JonasNowak/ns-conv/README.md

# Nintendo Switch v1 (Erista) → Clamshell Cyberdeck (`ns-conv`)

A complete, reversible hardware conversion that transforms an unpatched first-generation **Nintendo Switch v1 (2017 Erista, `HAC-001`)** into a **translucent lilac clamshell cyberdeck** integrating a **Drop × OLKB MIT Planck 40% ortholinear keyboard**, a **compact 38 mm USB HID trackball**, and an **internal slim UN 38.3 USB-C PD power bank**.

> [!TIP]
> **Interactive 3D WebGL CAD Studio & All-in-One Documentation Portal:**
> Open **[`docs/index.html`](docs/index.html)** (or visit the deployed GitHub Pages site) to spin the 3D cyberdeck, animate the clamshell lid (`0°–125°`), explode all 7 OpenSCAD STL meshes, switch between all 6 premade SLA factory colors, and browse/search all 10 engineering guides in one interactive app!

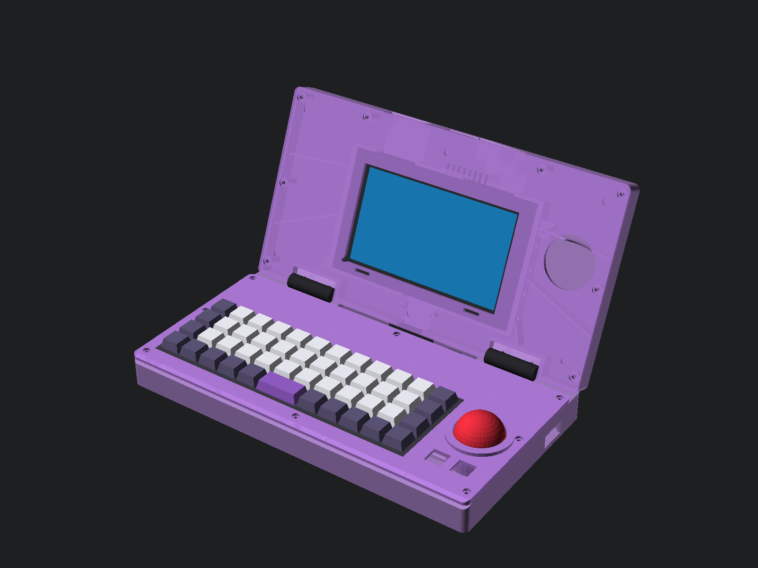
[picture p1: docs/renders/assembly_open_iso.png]
Open Clamshell Cyberdeck Render


| Exploded Assembly View | Closed Clamshell View (`0°`) |
| :---: | :---: |
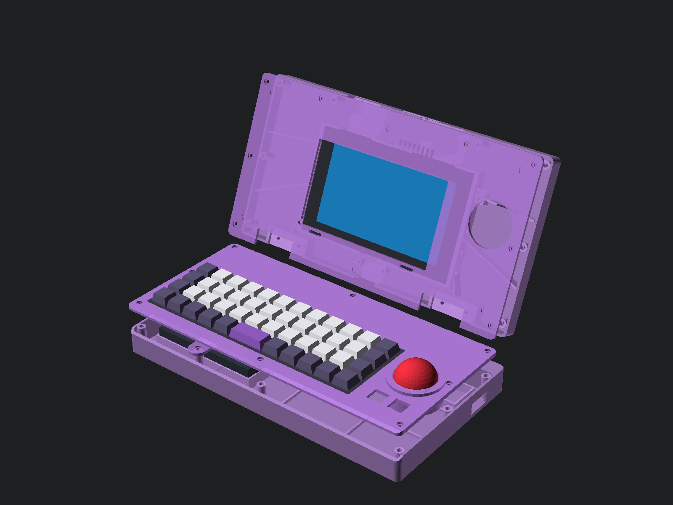
[picture p2: docs/renders/assembly_exploded.png]
Exploded View
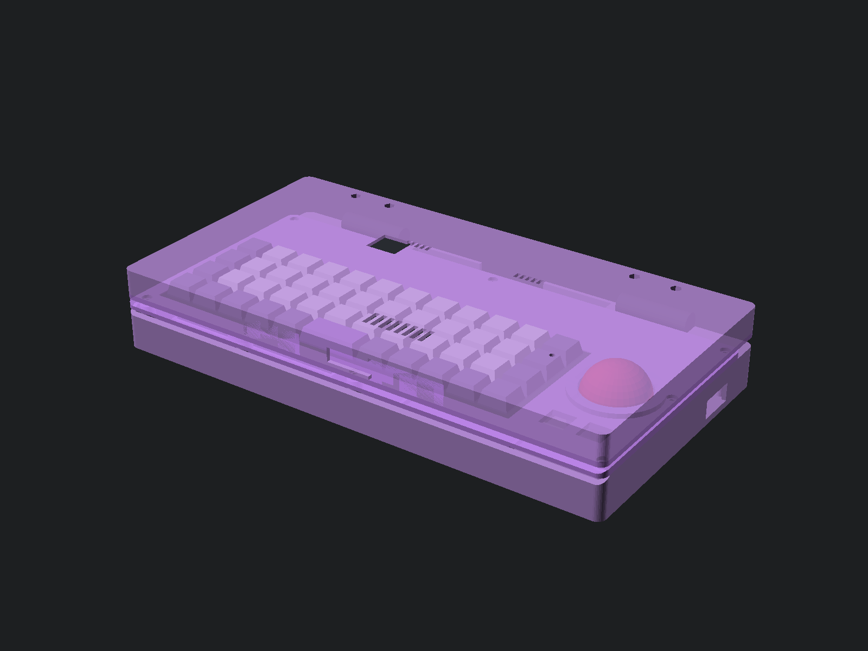
[picture p3: docs/renders/assembly_closed.png]
Closed View
|  |  |

---

## System Architecture Overview

```mermaid
flowchart LR
    subgraph LID["Upper Lid Assembly (Translucent Lilac SLA)"]
        SW_CORE["Switch v1 Core Assembly<br/>(LCD + Digitizer + Magnesium Midframe +<br/>Mainboard + Fan + 4310mAh Int. Battery)"]
        RCM_BTN["Recessed RCM Momentary Trigger<br/>(Right Rail Pin 10 → GND)"]
        RCM_BTN --> SW_CORE
    end

    subgraph HINGE["Torque-Balanced Dual Axis"]
        F_HINGE["2× Friction Torque Hinges<br/>(~0.40 N·m combined, 100–120° hold)"]
        USBC_FPC["Flexible Coaxial USB-C 3.1 Ribbon<br/>(Strained-relieved through hinge channel)"]
    end

    subgraph BASE["Base Deck Assembly (Translucent Lilac SLA)"]
        HUB["Internal Compact USB-C PD Hub<br/>(PD 3.0 15V Pass-Through + 3× USB 2.0/3.0 HID)"]
        PLANCK["Drop × MIT Planck Keyboard<br/>(Recessed PCB + Plate, QMK 6KRO)"]
        TBALL["Integrated Trackball<br/>(Ploopy Nano 2 QMK / 38mm Ball)"]
        PBANK["Slim UN 38.3 USB-C PD Power Bank<br/>(15V/2.6A+ PD Output, Fused & Thermally Isolated)"]
        EXT_USBC["Rear Panel USB-C PD Input/Data Port<br/>(Payload Injection & Charging)"]

        PLANCK -->|USB 2.0 HID| HUB
        TBALL -->|USB 2.0 HID| HUB
        PBANK -->|15V USB-PD + Inline 5A Fuse| HUB
        EXT_USBC <-->|Charging / RCM Injection| PBANK
        EXT_USBC -.->|Direct Switch Mode / OTG| HUB
    end

    SW_CORE <-->|Bottom USB-C Port via Low-Profile 90° Plug| USBC_FPC
    USBC_FPC <--> HUB
```

### Core Design Principles

1. **Zero-Destruction Reversibility:** The Switch's factory-bonded LCD, capacitive digitizer, die-cast magnesium midframe, thermal heatpipe/fan, and internal 4310 mAh battery remain intact as a single structural module inside the upper lid. No PCB traces are cut, and the risky LCD/digitizer adhesive separation is completely avoided.
2. **No High-Speed MIPI DSI Extension Across the Hinge:** Prior art shows that passively extending the Switch's 53-pin MIPI DSI LCD ribbon across a hinge causes severe signal reflection and black-screen failures. Keeping the mainboard and display together in the lid means **only a single USB-C cable** crosses the hinge into the base.
3. **Horizon OS Safety First & Mainline Chimera Linux 6.18 (`chimera-l4s`):** Stock `sysNAND` remains 100% unmodified for online play. Custom firmware (**Kefir `v927` AIO**) and Linux (**[`../chimera-l4s`](../chimera-l4s) — Chimera Linux `aarch64` with Linux `6.18.0-enigma-r20-erista+`** + optional **Switchroot L4T Ubuntu** rescue path) run strictly from the external microSD card (`emmc=0`, `LABEL=SWR-CHI` + `emuNAND` with `exosphere`/`dns.mitm` telemetry blanking).
4. **Translucent Lilac Industrial 3D Printing:** All enclosure components are designed in parametric OpenSCAD (`cad/`) for **SLA Translucent Resin with custom Pantone Lilac dyeing** and clear UV-protective urethane coating via **PCBWay (`UTR-8100 Transparent`)** or **JLC3DP (`8001 Translucent`)**.

---

## Build Phase Status & Deliverables

This project is executed strictly phase-by-phase with user sign-off between phases:

| Phase | Deliverable | Document / Path | GitHub Issue | Status |
| :--- | :--- | :--- | :--- | :--- |
| **1** | **Research Summary** (Prior art, hardware verification, OS HID behavior, trackball & battery trade-offs) | [`docs/research.md`](docs/research.md) | [#1](https://github.com/JonasNowak/ns-conv/issues/1) | **Complete** |
| **2** | **Bill of Materials (BOM)** (Every part, tool, consumable, EUR pricing, suppliers & alternatives) | [`docs/bom.md`](docs/bom.md) & [`hardware/BOM.csv`](hardware/BOM.csv) | [#2](https://github.com/JonasNowak/ns-conv/issues/2) | **Complete** |
| **3** | **Teardown Plan** (Step-by-step Switch v1 & Drop Planck non-destructive disassembly) | [`docs/teardown.md`](docs/teardown.md) | [#3](https://github.com/JonasNowak/ns-conv/issues/3) | **Complete** |
| **4** | **Electronics & Wiring Plan** (USB-C hub vs harness, PD power-bank topology, fusing, thermals) | [`docs/wiring.md`](docs/wiring.md) & [`hardware/`](hardware/) | [#4](https://github.com/JonasNowak/ns-conv/issues/4) | **Complete** |
| **5** | **Parametric OpenSCAD CAD Package** (`config.scad`, lid, base, hinge brackets, jigs, STLs) | [`cad/`](cad/) & [`docs/cad-overview.md`](docs/cad-overview.md) | [#5](https://github.com/JonasNowak/ns-conv/issues/5) | **Complete** |
| **6** | **3D Print Order Specification** (PCBWay / JLC3DP all 6 premade factory SLA color options & test-fit jig) | [`docs/print-spec.md`](docs/print-spec.md) | [#6](https://github.com/JonasNowak/ns-conv/issues/6) | **Complete** |
| **7** | **Assembly Guide** (Step-by-step mechanical & electrical build, torque sequence, first boot) | [`docs/assembly.md`](docs/assembly.md) | [#7](https://github.com/JonasNowak/ns-conv/issues/7) | **Complete** |
| **8** | **Software Setup Guide** (`../chimera-l4s` Linux 6.18 Enigma R20 + Kefir `v927` `emuNAND` + SD deployment script) | [`docs/software.md`](docs/software.md) & [`software/`](software/) | [#8](https://github.com/JonasNowak/ns-conv/issues/8) | **Complete** |
| **9** | **Test & Acceptance Checklist** (Horizon OS, L4T Linux, USB HID, PD charging, thermals, hinges) | [`docs/testing.md`](docs/testing.md) | [#9](https://github.com/JonasNowak/ns-conv/issues/9) | **Complete** |
| **10** | **Risk Register** (Top 10 technical, safety, and ban risks with mitigations) | [`docs/risks.md`](docs/risks.md) | [#10](https://github.com/JonasNowak/ns-conv/issues/10) | **Complete** |

---

## Exposed External Ports & Wireless Connectivity Summary

- **Wi-Fi & Bluetooth (`BCM4356` 2×2 MIMO 802.11ac 2.4/5 GHz + BT 4.1):** Both factory Switch `U.FL` coaxial cables and flat PCB patch antennas remain plugged into the mainboard and sit inside the **100% RF-transparent non-conductive SLA upper lid (`2.5 mm` wall)**, preserving full dual-band Wi-Fi and wireless Joy-Con / Bluetooth range in both Horizon OS and L4T Ubuntu Linux.
- **Right-Side Flush I/O Window (`cad/base_bottom.scad`):** Exposes **`1× USB-A 3.0 SuperSpeed (5 Gbps)` port** + **`1× 4K HDMI` output port** directly from the internal 5-in-1 USB-C PD hub (`HUB-01`) for external flash drives, SDR dongles, Ethernet adapters, or an external monitor.
- **Rear Panel I/O (`cad/base_bottom.scad`):** Exposes **`1× USB-C PD Charging Socket (`CAB-03`)`**, the **Recessed Center RCM / Direct Switch USB-C Coupler Pocket**, and the **Master Battery Cutoff Switch (`ELC-02`)**.
- **Top & Bottom Lid I/O (`cad/lid_rear.scad`):** Exposes the Switch's native **Power button**, **Volume `+/-`**, **`3.5 mm` audio jack**, **Game Card slot**, **Top Heatsink Exhaust**, **Rear Intake Louvers**, **microSDXC slot**, and **Recessed RCM Momentary Pinhole Button (`RCM-01`)**.

---

## Repository Structure

```text
ns-conv/
├── README.md                 # Project overview, architecture, and build phase tracker
├── docs/
│   ├── research.md           # Phase 1: Prior art, donor verification & subsystem trade-offs
│   ├── bom.md                # Phase 2: Bill of Materials & EUR budget (AliExpress vs DE)
│   ├── teardown.md           # Phase 3: Non-destructive Switch v1 & Planck teardown
│   ├── wiring.md             # Phase 4: Internal USB-C hub, PD power bank & fusing plan
│   ├── cad-overview.md       # Phase 5: Dimensioned CAD overview & verification checklist
│   ├── print-spec.md         # Phase 6: PCBWay / JLC3DP premade SLA print specification
│   ├── assembly.md           # Phase 7: Mechanical assembly & first power-on guide
│   ├── software.md           # Phase 8: Full software guide (../chimera-l4s Linux 6.18 + Kefir v927)
│   ├── testing.md            # Phase 9: Test & acceptance checklist
│   ├── risks.md              # Phase 10: Top 10 risk register & recovery playbooks
│   └── renders/              # OpenSCAD PNG renders of all 7 parts + open/closed/exploded views
├── cad/                      # Phase 5: Parametric OpenSCAD sources, Makefile, STLs & 3MFs
├── hardware/                 # BOM.csv, wiring-diagram.mmd, and component datasheets.md
└── software/                 # deploy-chimera-kefir-sd.sh staging script & chimera-l4s integration
```
