JonasNowak/ns-conv/docs/renders/base_bottom.png

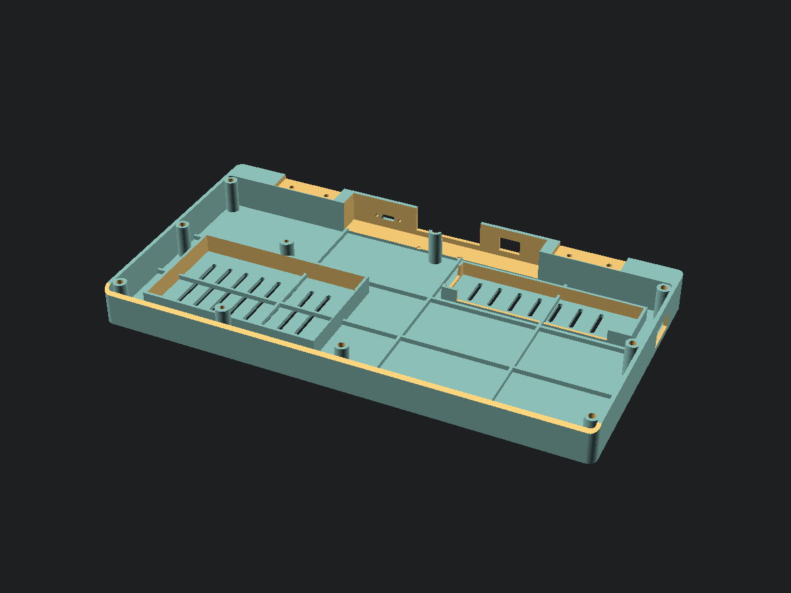
docs/renders/base_bottom.png
