JonasNowak/ns-conv/docs/renders/base_top_deck.png

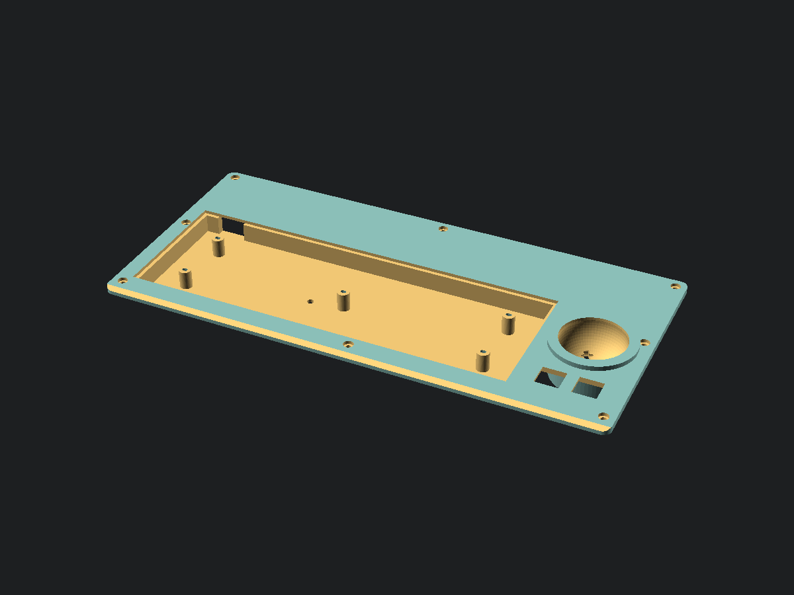
docs/renders/base_top_deck.png
