JonasNowak/ns-conv/docs/renders/battery_retainer.png

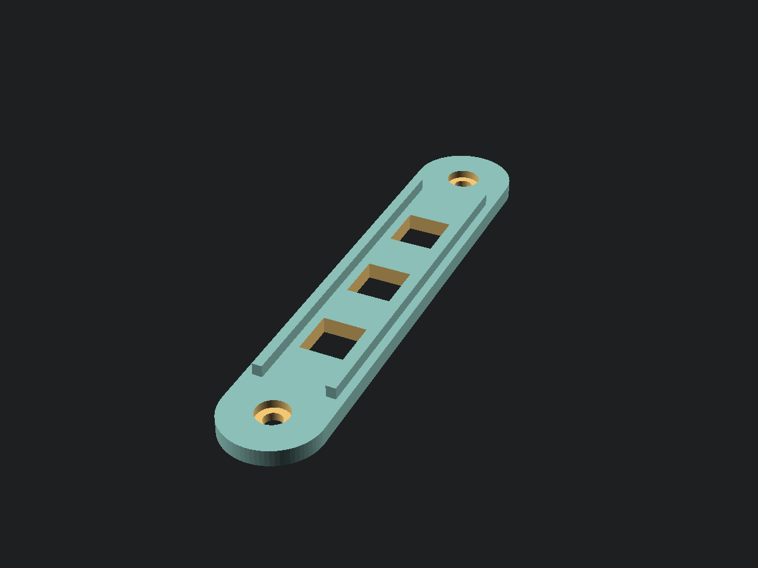
docs/renders/battery_retainer.png
