JonasNowak/ns-conv/docs/renders/cable_clamp.png

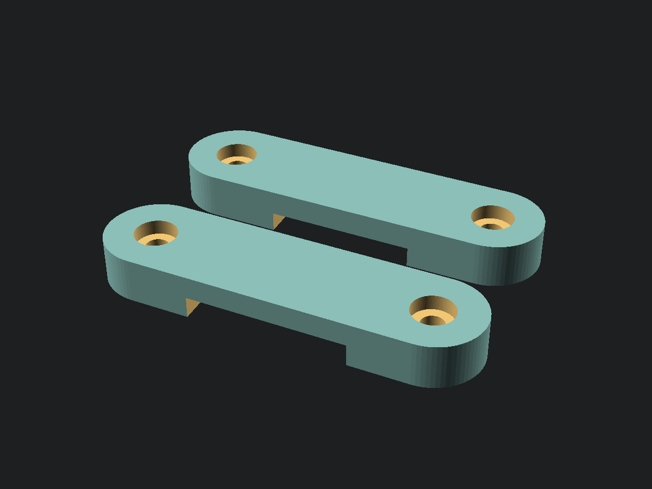
docs/renders/cable_clamp.png
