JonasNowak/ns-conv/docs/renders/lid_bezel.png

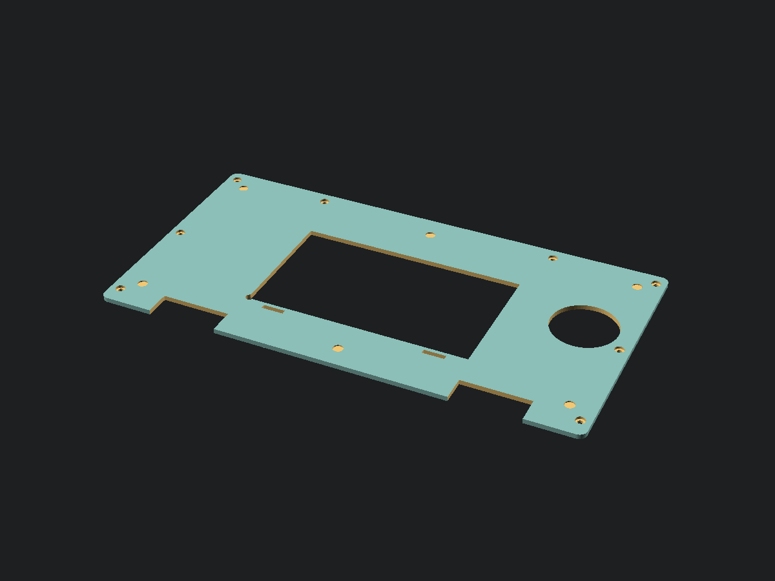
docs/renders/lid_bezel.png
