JonasNowak/ns-conv/hardware/BOM.csv

ID | Category | Component | Specification | Qty | AliExpress_Total_EUR | DE_Retail_Total_EUR | AliExpress_Search_URL | DE_Supplier_URL | Notes_And_Alternatives
DON-01 | Donor Hardware | Nintendo Switch v1 (2017 Erista) | MOD. HAC-001 unpatched Tegra X1 T210 | 1 | 0.00 | 0.00 | https://ismyswitchpatched.com/ | https://ismyswitchpatched.com/ | User-owned donor console
DON-02 | Donor Hardware | Drop x OLKB MIT Planck Keyboard | Planck Rev 6.x (233x81mm PCB + Plate + 47 MX Switches + Keycaps) | 1 | 0.00 | 0.00 | https://github.com/olkb/olkb_parts | https://github.com/olkb/olkb_parts | User-owned donor keyboard
DON-03 | Donor Hardware | Spare Right Joy-Con Rail / RCM Jig Parts | OEM or spare Right Joy-Con rail flex & RCM jig (Pin 10 RCM to GND) | 1 | 0.00 | 0.00 | https://ismyswitchpatched.com/ | https://ismyswitchpatched.com/ | User-owned spare Joy-Con hardware
PER-01 | Peripherals & Power | 38mm QMK Trackball (Ploopy Nano 2 Architecture) | 38mm ball + RP2040-Zero + PMW3360/PAW3222 breakout + 3x MR63ZZ bearings (QMK USB-C) | 1 | 21.50 | 60.00 | https://www.aliexpress.com/w/wholesale-PMW3360-module.html | https://ploopy.co/shop/nano-trackball/ | AliExpress DIY kit (21.50 EUR) vs pre-built Ploopy Nano 2 shipped to DE (60.00 EUR) or ProtoArc EM04 (18.50 EUR)
PWR-01 | Peripherals & Power | INIU Carry P50-E1 / BI-B62 45W Slim Power Bank | 10000mAh 37Wh 15V/3A USB-C PD Pass-Through UN38.3 (110x68x18.5mm 210g) | 1 | 25.99 | 33.99 | https://www.aliexpress.com/w/wholesale-INIU-45W-power-bank.html | https://www.amazon.de/s?k=INIU+45W+Powerbank+10000mAh | Ships from DE/PL EU warehouse; 20000mAh INIU P62-E1 65W alt (44.99 EUR)
HUB-01 | Peripherals & Power | 100W PD 5-in-1 USB-C Hub (UGREEN Revodok 105 / Baseus) | 100W USB-C PD Pass-Through + 3x USB-A + 4K HDMI (115x27x12mm) | 1 | 6.50 | 12.99 | https://www.aliexpress.com/w/wholesale-UGREEN-USB-C-Hub-100W-PD.html | https://www.amazon.de/s?k=UGREEN+Revodok+105+USB+C+Hub | Anker 332 5-in-1 100W PD alt (19.99 EUR)
STR-01 | Optional Storage & Tools | 256GB microSDXC U3 A2 V30 Card | Samsung PRO Plus or Lexar Play 256GB microSDXC | 1 | 16.90 | 22.99 | https://www.aliexpress.com/w/wholesale-Samsung-PRO-Plus-256GB.html | https://www.amazon.de/s?k=Samsung+PRO+Plus+256GB+microSDXC | Skip if already owned
CAB-01 | Cabling & Protection | 90-Degree Flat Flexible USB-C 3.1 Ribbon Cable | 20cm Right-Angle Male-to-Female FPC Ribbon 100W PD 10Gbps (Lid to Base) | 1 | 3.40 | 11.99 | https://www.aliexpress.com/w/wholesale-ADT-Link-USB-C-90-degree-flat-20cm.html | https://www.amazon.de/s?k=USB+C+90+Grad+Flachkabel+Verl%C3%A4ngerung+100W | Routes across hinge channel
CAB-02 | Cabling & Protection | Short Flat Silicone USB-A to USB-C Cables (2-Pack) | 15cm USB-A to USB-C data cables (Planck & Trackball to Hub) | 1 | 1.80 | 7.99 | https://www.aliexpress.com/w/wholesale-flat-silicone-USB-A-to-USB-C-15cm.html | https://www.amazon.de/s?k=USB+A+auf+USB+C+Kabel+15cm+2er | 2 cables included
CAB-03 | Cabling & Protection | Rear Panel-Mount USB-C PD Extension Socket | 20cm Female-to-Male M2/M3 Panel Mount 16mm pitch 100W PD | 1 | 2.10 | 8.99 | https://www.aliexpress.com/w/wholesale-USB-C-panel-mount-extension-cable-100W.html | https://www.amazon.de/s?k=USB+C+Einbaubuchse+Panel+Mount+100W | External rear charging & payload port
ELC-01 | Cabling & Protection | Inline 5A Blade Fuse Holder + 5A Fast Fuses | 16 AWG Inline Mini/ATO Blade Fuse Holder + 5A Fuses (VBUS protection) | 1 | 1.50 | 5.99 | https://www.aliexpress.com/w/wholesale-16AWG-inline-blade-fuse-holder-5A.html | https://www.amazon.de/s?k=Flachsicherungshalter+16AWG+5A | Mandatory battery line overcurrent fuse
ELC-02 | Cabling & Protection | USB-C PD Power Cutoff Switch Cable | 15-20cm Male-to-Female Inline High-Current Power Toggle Switch | 1 | 1.60 | 7.99 | https://www.aliexpress.com/w/wholesale-USB-C-switch-extension-cable.html | https://www.amazon.de/s?k=USB+C+Schalter+Kabel+Power+Switch | Cuts power bank output during storage
RCM-01 | Cabling & Protection | 6x6x5mm Momentary Tactile Pushbutton Switch | Through-hole/SMD tactile switch wired to spare Right Joy-Con rail Pin 10 & GND | 1 | 0.99 | 2.99 | https://www.aliexpress.com/w/wholesale-6x6x5mm-tactile-switch.html | https://www.amazon.de/s?k=Taster+6x6x5mm | Uses user-owned spare Joy-Con rail/RCM hardware
PRT-01 | 3D-Printed SLA Shell | Custom 7-Part SLA Enclosure Set (Turnkey Factory-Dyed Translucent Lilac) | PCBWay SLA UTR-8100 Transparent + Factory Pantone 2577C Lilac Dyeing + Clear Coat (incl. DE IOSS shipping) | 1 | 145.00 | 145.00 | https://www.pcbway.com/rapid-prototyping/manufacture/?type=2 | https://www.pcbway.com/rapid-prototyping/manufacture/?type=2 | 100% premade factory-dyed Translucent Lilac (145.00 EUR w/ clear internal clamps or 165.00 EUR all dyed; JLC3DP un-dyed 8001 clear alt: 50.00 EUR)
MEC-01 | Mechanical & Fasteners | Adjustable Friction Torque Hinges (42.9x36.5x12.7mm Pair) | Southco E6-10-301-20 / CL226 Screw-Adjustable Torque Hinges (0-0.80 Nm each) | 2 | 5.90 | 27.60 | https://www.aliexpress.com/w/wholesale-E6-10-301-hinge.html | https://de.rs-online.com/web/c/?searchTerm=E6-10-301-20 | Amazon.de pair alt: 14.99 EUR
MEC-02 | Mechanical & Fasteners | M2 / M2.5 / M3 Stainless Steel Screw & Hex Nut Kit | A2-70 ISO 7380 / DIN 912 Screws + DIN 934 Hex Nuts & Washers Assortment | 1 | 3.60 | 11.99 | https://www.aliexpress.com/w/wholesale-M2-M2.5-M3-stainless-screw-nut-assortment.html | https://www.amazon.de/s?k=M2+M2.5+M3+Edelstahl+Schrauben+Sortiment+DIN+912 | Used across lid midframe | Planck plate | hinges | and shell
MEC-03 | Mechanical & Fasteners | M2 & M3 Knurled Brass Threaded Inserts Assortment | M2x3x3.2mm & M3x4x4.5mm Inserts (cold-press + CA bonded in blind SLA bosses) | 1 | 1.80 | 7.99 | https://www.aliexpress.com/w/wholesale-M2-M3-knurled-brass-insert.html | https://www.amazon.de/s?k=M2+M3+Einpressmutter+Messing+Gewindeeinsatz | Cold-press into thermoset SLA resin
MEC-04 | Mechanical & Fasteners | Silicone Rubber Feet + Bezel Bumpers + 1.5mm EVA Foam Pad | 10x3mm Feet + 6x1.5mm Lid Bumpers + 1.5mm Battery Bay Isolation Foam | 1 | 1.60 | 6.99 | https://www.aliexpress.com/w/wholesale-silicone-rubber-feet-bumper-pad.html | https://www.amazon.de/s?k=Elastikpuffer+Gummif%C3%BC%C3%9Fe+selbstklebend+EVA+Moosgummi | Cushions power bank and lid closure
TOL-01 | Optional Storage & Tools | Precision Screwdriver & Spudger Set (Y00 + JIS 00 + H1.5) | 25-in-1 Precision Driver Kit (AliExpress) or iFixit Moray 32-Bit Kit (Amazon.de) | 1 | 3.90 | 19.99 | https://www.aliexpress.com/w/wholesale-precision-screwdriver-set-Y00-switch.html | https://www.amazon.de/s?k=iFixit+Moray+Bit+Set+Y00 | Skip if already owned
TOL-02 | Optional Storage & Tools | Medium Cyanoacrylate Gel + Blue Threadlocker 243 | CA Gel for SLA Brass Inserts + Medium Threadlocker for Hinge Screws | 1 | 2.40 | 8.99 | https://www.aliexpress.com/w/wholesale-threadlocker-243.html | https://www.amazon.de/s?k=Liqui+Moly+Schraubensicherung+mittelfest | Skip if already owned
