JonasNowak/ns-conv/cad/3mf/lid_bezel.3mf

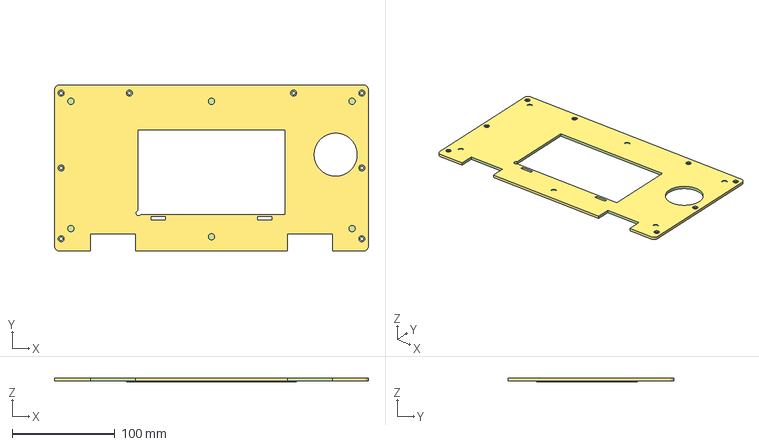
[picture p9: CAD file, 2026-11-07]
cad/3mf/lid_bezel.3mf
306.0 x 162.0 x 4.20 mm
