JonasNowak/ns-conv/docs/models/test_fit_jig.stl

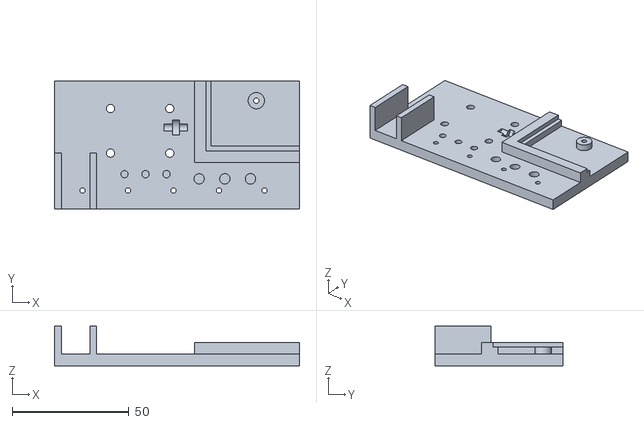
[picture p10: CAD file, 2026-11-07]
docs/models/test_fit_jig.stl
105.0 x 55.0 x 17.0
