JonasNowak/ns-conv/cad/3mf/base_top_deck.3mf

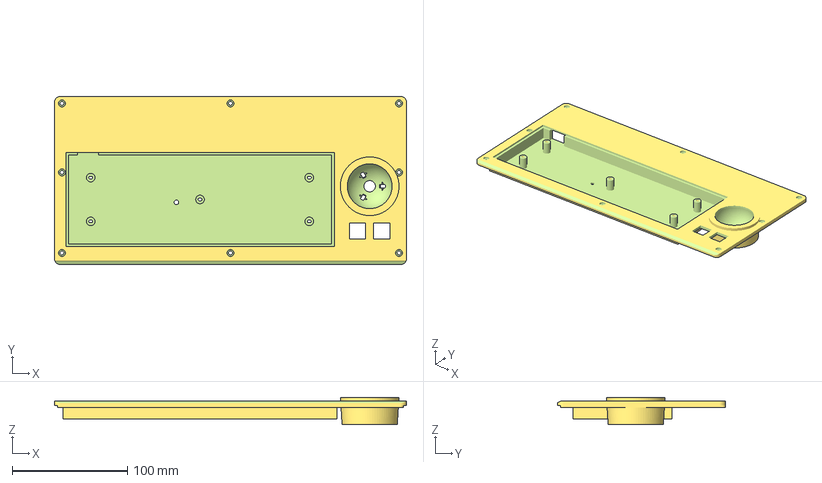
[picture p11: CAD file, 2026-11-07]
cad/3mf/base_top_deck.3mf
306.0 x 146.0 x 23.5 mm
