JonasNowak/ns-conv/docs/models/base_bottom.stl

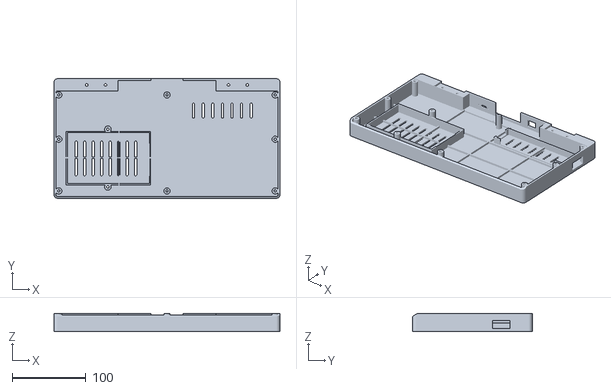
[picture p12: CAD file, 2026-11-07]
docs/models/base_bottom.stl
306.0 x 162.0 x 24.5
