JonasNowak/ns-conv/cad/3mf/cable_clamp.3mf

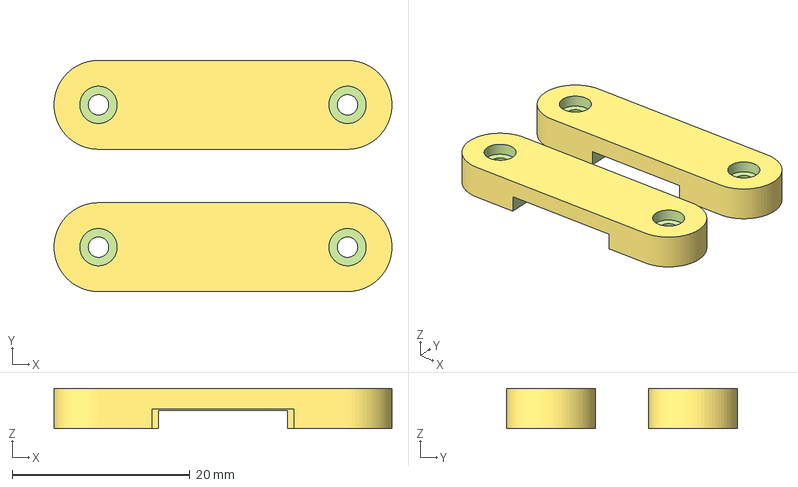
[picture p13: CAD file, 2026-11-07]
cad/3mf/cable_clamp.3mf
38.0 x 26.0 x 4.50 mm
