JonasNowak/ns-conv/docs/models/battery_retainer.stl

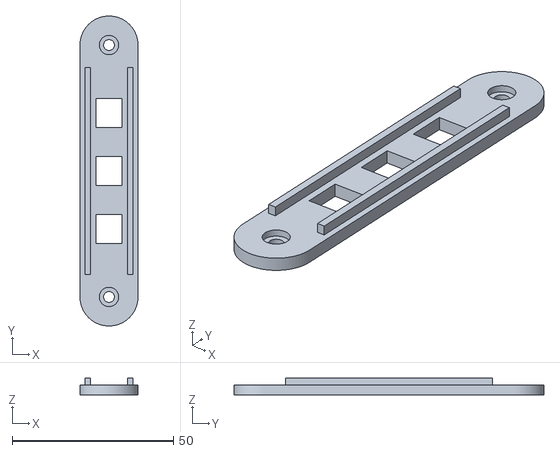
[picture p14: CAD file, 2026-11-07]
docs/models/battery_retainer.stl
18.0 x 96.0 x 5.18
