JonasNowak/ns-conv/cad/3mf/lid_rear.3mf

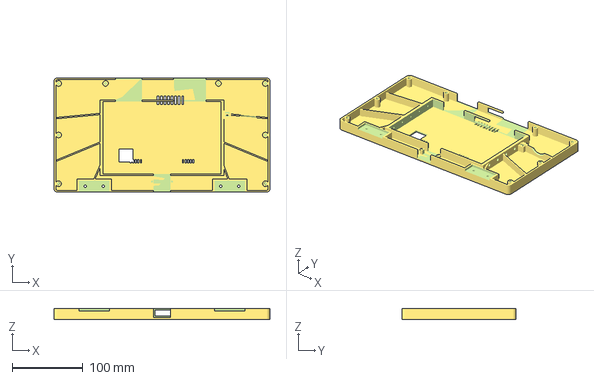
[picture p15: CAD file, 2026-11-07]
cad/3mf/lid_rear.3mf
306.0 x 162.0 x 15.0 mm
