JonasNowak/ns-conv/(list of files, cad)

Other CAD files:
cad/3mf/base_bottom.3mf
docs/models/base_top_deck.stl
cad/3mf/test_fit_jig.3mf
docs/models/cable_clamp.stl
docs/models/lid_rear.stl
cad/3mf/battery_retainer.3mf
docs/models/lid_bezel.stl
cad/stl/base_bottom.stl
cad/stl/base_top_deck.stl
cad/stl/battery_retainer.stl
cad/stl/cable_clamp.stl
cad/stl/lid_bezel.stl
cad/stl/lid_rear.stl
cad/stl/test_fit_jig.stl
