JonasNowak/ns-conv/docs/renders/test_fit_jig.png

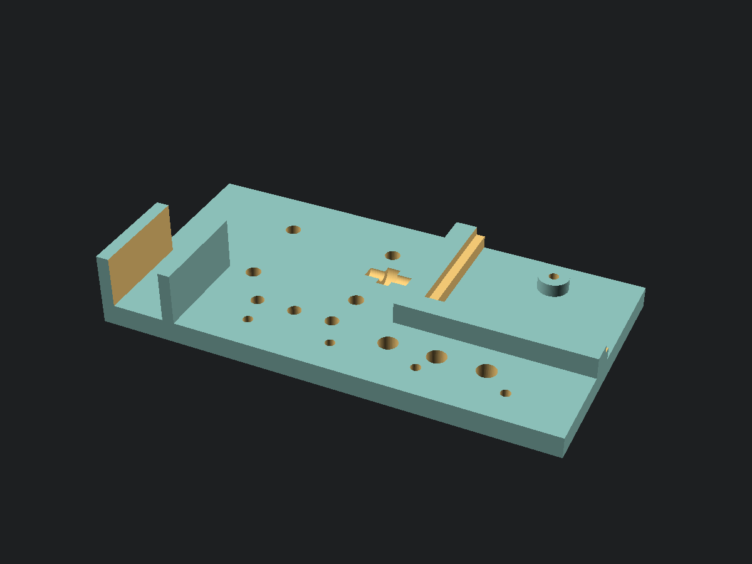
docs/renders/test_fit_jig.png
