JonasNowak/ns-conv/(commit log)

2026-11-07 docs(research): record confirmed user decisions on trackball, power bank, SLA service, and Planck Rev 6
2026-11-07 docs(bom): add Phase 2 Bill of Materials (docs/bom.md and hardware/BOM.csv) with DE/EUR pricing
    [BOM.csv]
2026-11-07 docs(bom): add AliExpress mass-sourcing pricing, user-owned Joy-Con spares, and opaque vs translucent SLA comparison
    [BOM.csv]
2026-11-07 docs(teardown): add Phase 3 non-destructive Switch v1 and Drop Planck teardown guide
2026-11-07 docs(wiring): add Phase 4 electronics, USB-C PD hub, inline fuse, and SPI wiring plan
2026-11-07 feat(cad): add parametric OpenSCAD sources, Makefile, and CI workflow
    [assembly_preview.scad, base_bottom.scad, base_top_deck.scad, battery_retainer.scad, cable_clamp.scad, config.scad, lid_bezel.scad, lid_rear.scad]
2026-11-07 build(cad): export print-ready STL/3MF meshes, PNG renders, and dimensioned overview
    [base_bottom.3mf, base_bottom.stl, base_top_deck.3mf, base_top_deck.stl, battery_retainer.3mf, battery_retainer.stl, cable_clamp.3mf, cable_clamp.stl]
2026-11-07 docs(print-spec): add Phase 6 JLC3DP/PCBWay translucent lilac SLA print order spec and dye protocol
2026-11-07 docs(print-spec,bom): switch to 100% premade PCBWay factory-dyed translucent lilac with zero home dyeing
    [BOM.csv]
2026-11-07 docs(print-spec,bom): list all 6 premade factory SLA color options side-by-side
2026-11-07 docs(assembly): complete Phase 7 step-by-step mechanical and electrical assembly guide
2026-11-07 feat(pages): add interactive 3D WebGL CAD studio and complete 10-phase documentation portal
    [base_bottom.stl, base_top_deck.stl, battery_retainer.stl, cable_clamp.stl, lid_bezel.stl, lid_rear.stl, test_fit_jig.stl]
2026-11-07 fix(cad,pages): orient Planck 2u spacebar row to front edge and fix Pages CI workflow on private repo
    [assembly_preview.scad]
